jahofmann/clevercoffee-hardware/CleverCoffee_ESP32_SMD/spice/TwoResistors.spice

.SUBCKT TwoResistors 1 2 3
R1 1 3 200
R2 2 3 200
.ENDS
