jahofmann/clevercoffee-hardware/CleverCoffee_ESP32_SMD/CleverCoffee_ESP32.kicad_pcb

## KiCad design CleverCoffee_ESP32_SMD/CleverCoffee_ESP32.kicad_pcb (2023-09-08)

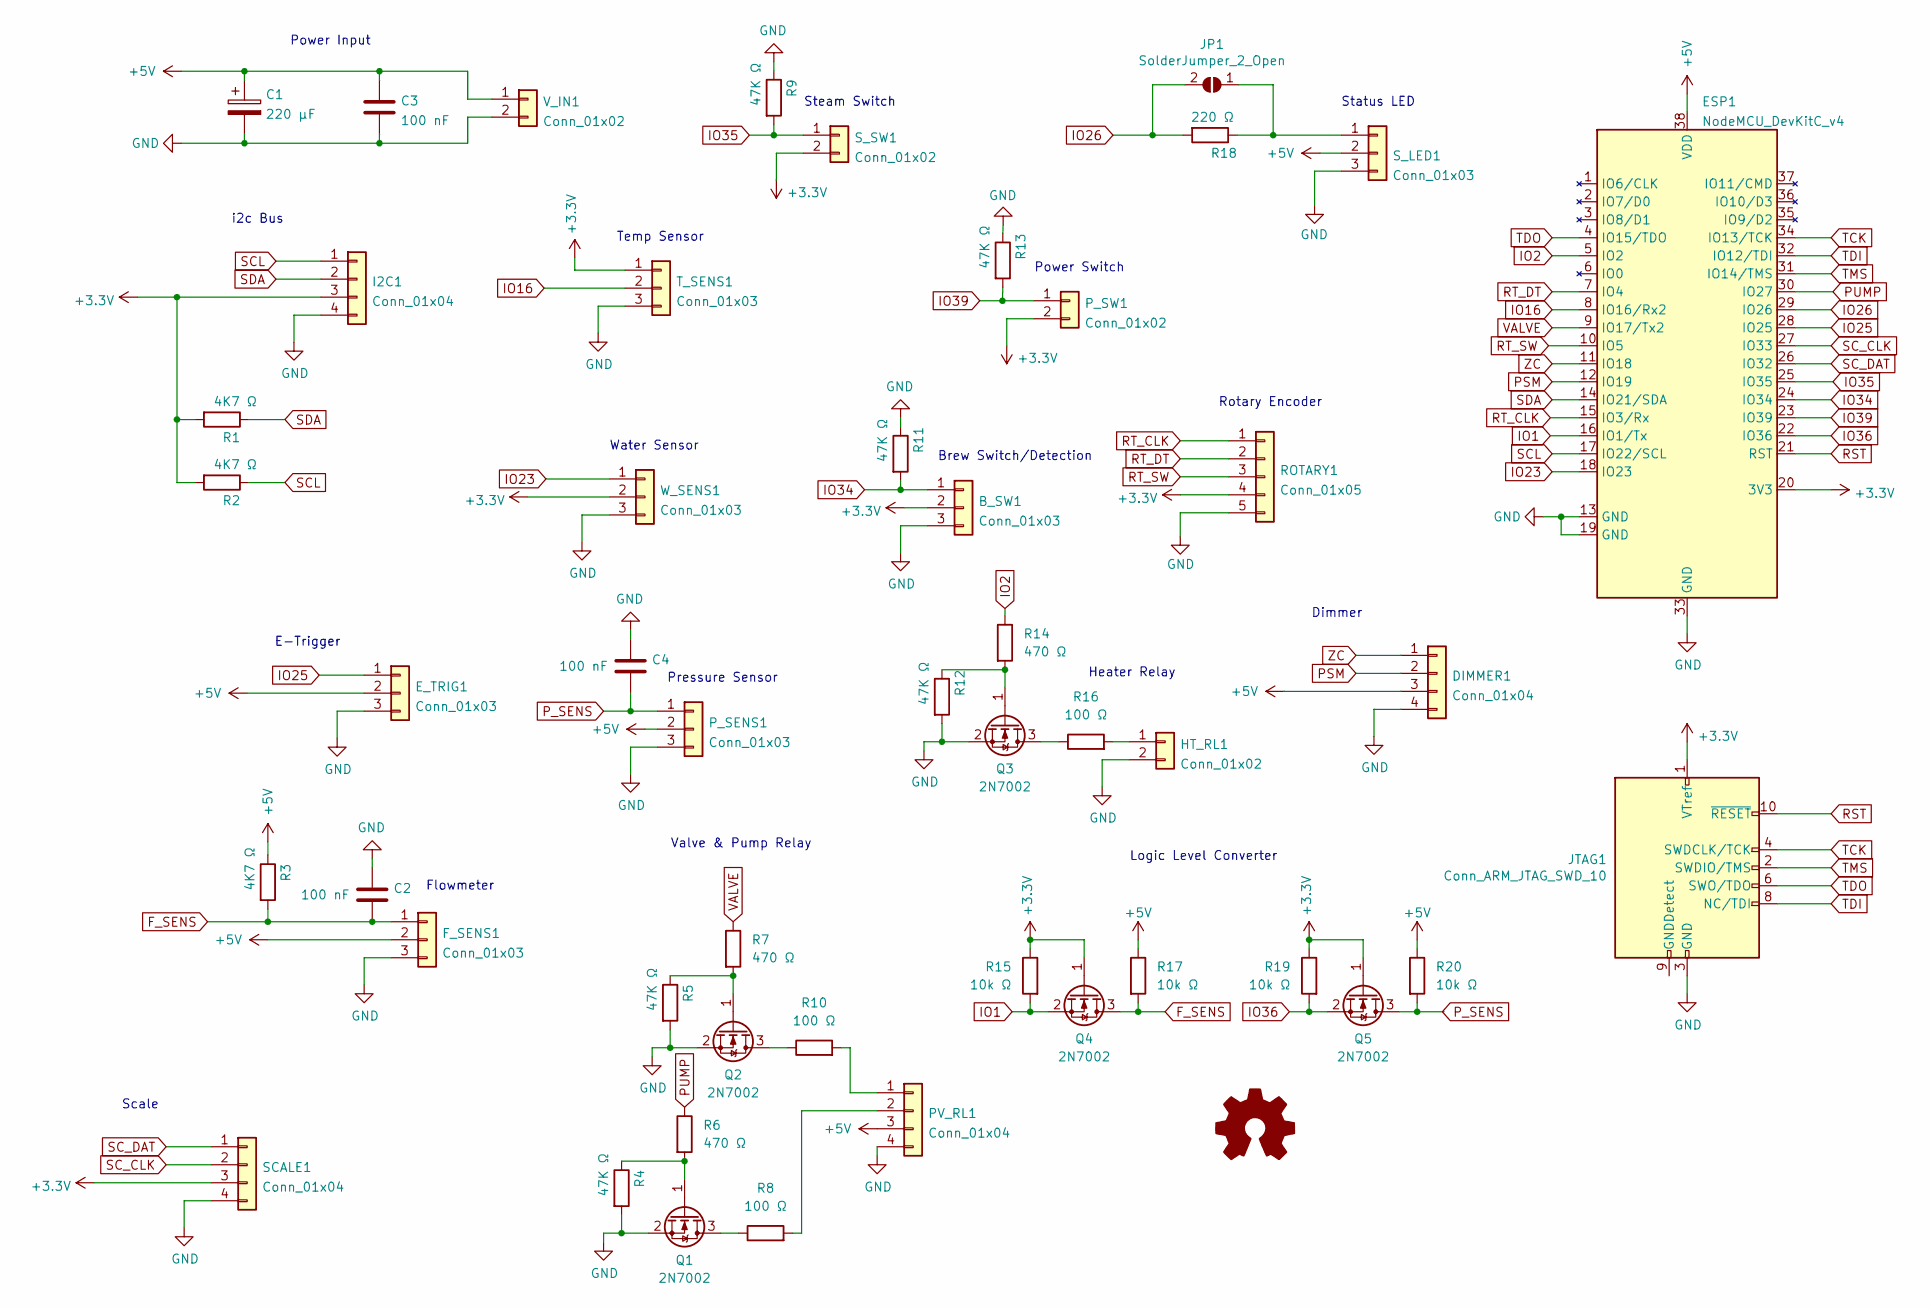
[picture p1: schematic CleverCoffee_ESP32.kicad_sch, ESP32 Breakout Board]

Parts:
B_SW1: Conn_01x03; PinSocket_1x03_P2.54mm_Vertical; JLCPCB BOM false
C1: 220 μF; CP_Radial_D8.0mm_P3.80mm; JLCPCB BOM false
C2, C3, C4: 100 nF; C_0603_1608Metric; LCSC Part C14663
DIMMER1: Conn_01x04; PinSocket_1x04_P2.54mm_Vertical; JLCPCB BOM false
ESP1: NodeMCU_DevKitC_v4; NodeMCU DevKitC v4; JLCPCB BOM false
E_TRIG1: Conn_01x03; PinSocket_1x03_P2.54mm_Vertical; JLCPCB BOM false
F_SENS1: Conn_01x03; PinSocket_1x03_P2.54mm_Vertical; JLCPCB BOM false
HT_RL1: Conn_01x02; PinSocket_1x02_P2.54mm_Vertical; JLCPCB BOM false
I2C1: Conn_01x04; PinSocket_1x04_P2.54mm_Vertical; JLCPCB BOM false
JP1: SolderJumper_2_Open; SolderJumper-2_P1.3mm_Open_Pad1.0x1.5mm; JLCPCB BOM false
JTAG1: Conn_ARM_JTAG_SWD_10; PinHeader_2x05_P2.54mm_Vertical; JLCPCB BOM false
PV_RL1: Conn_01x04; PinSocket_1x04_P2.54mm_Vertical; JLCPCB BOM false
P_SENS1: Conn_01x03; PinSocket_1x03_P2.54mm_Vertical; JLCPCB BOM false
P_SW1: Conn_01x02; PinSocket_1x02_P2.54mm_Vertical; JLCPCB BOM false
Q1, Q2, Q3, Q4, Q5: 2N7002; SOT-23; LCSC Part C8545
R1, R2, R3: 4K7 Ω; C_0603_1608Metric; LCSC Part C23162
R4, R5, R9, R11, R12, R13: 47K Ω; C_0603_1608Metric; LCSC Part C25819
R6, R7, R14: 470 Ω; C_0603_1608Metric; LCSC Part C23179
R8, R10, R16: 100 Ω; C_0603_1608Metric; LCSC Part C22775
R15, R17, R19, R20: 10k Ω; R_0603_1608Metric; LCSC Part C25804
R18: 220 Ω; C_0603_1608Metric; LCSC Part C22962
ROTARY1: Conn_01x05; PinSocket_1x05_P2.54mm_Vertical; JLCPCB BOM false
SCALE1: Conn_01x04; PinSocket_1x04_P2.54mm_Vertical; JLCPCB BOM false
S_LED1: Conn_01x03; PinSocket_1x03_P2.54mm_Vertical; JLCPCB BOM false
S_SW1: Conn_01x02; PinSocket_1x02_P2.54mm_Vertical; JLCPCB BOM false
T_SENS1: Conn_01x03; PinSocket_1x03_P2.54mm_Vertical; JLCPCB BOM false
V_IN1: Conn_01x02; PinSocket_1x02_P2.54mm_Vertical; JLCPCB BOM false
W_SENS1: Conn_01x03; PinSocket_1x03_P2.54mm_Vertical; JLCPCB BOM false

Connections:
+3V3: B_SW1.2, ESP1.20 (3V3), I2C1.3, JTAG1.1 (VTref), P_SW1.2, Q4.1 (G), Q5.1 (G), R1.2, R2.2, R15.1, R19.1, ROTARY1.4, SCALE1.3, S_SW1.2, T_SENS1.1, W_SENS1.2
+5V: C1.1, C3.1, DIMMER1.3, ESP1.38 (VDD), E_TRIG1.2, F_SENS1.2, PV_RL1.3, P_SENS1.2, R3.1, R17.1, R20.1, S_LED1.2, V_IN1.1
F_SENS: C2.2, F_SENS1.1, Q4.3 (D), R3.2, R17.2
GND: B_SW1.3, C1.2, C2.1, C3.2, C4.1, DIMMER1.4, ESP1.13 (GND), ESP1.19 (GND), ESP1.33 (GND), E_TRIG1.3, F_SENS1.3, HT_RL1.2, I2C1.4, JTAG1.3 (GND), JTAG1.5 (GND), PV_RL1.4, P_SENS1.3, Q1.2 (S), Q2.2 (S), Q3.2 (S), R4.2, R5.2, R9.1, R11.1, R12.2, R13.1, ROTARY1.5, SCALE1.4, S_LED1.3, T_SENS1.3, V_IN1.2, W_SENS1.3
IO1: ESP1.16 (IO1/Tx), Q4.2 (S), R15.2
IO2: ESP1.5 (IO2), R14.1
IO16: ESP1.8 (IO16/Rx2), T_SENS1.2
IO23: ESP1.18 (IO23), W_SENS1.1
IO25: ESP1.28 (IO25), E_TRIG1.1
IO26: ESP1.29 (IO26), JP1.2 (B), R18.2
IO34: B_SW1.1, ESP1.24 (IO34), R11.2
IO35: ESP1.25 (IO35), R9.2, S_SW1.1
IO36: ESP1.22 (IO36), Q5.2 (S), R19.2
IO39: ESP1.23 (IO39), P_SW1.1, R13.2
unnamed: HT_RL1.1, R16.2
unnamed: JP1.1 (A), R18.1, S_LED1.1
unnamed: PV_RL1.1, R10.2
unnamed: PV_RL1.2, R8.2
unnamed: Q1.3 (D), R8.1
unnamed: Q1.1 (G), R4.1, R6.2
unnamed: Q2.3 (D), R10.1
unnamed: Q2.1 (G), R5.1, R7.2
unnamed: Q3.3 (D), R16.1
unnamed: Q3.1 (G), R12.1, R14.2
PSM: DIMMER1.2, ESP1.12 (IO19)
PUMP: ESP1.30 (IO27), R6.1
P_SENS: C4.2, P_SENS1.1, Q5.3 (D), R20.2
RST: ESP1.21 (RST), JTAG1.10 (~RESET)
RT_CLK: ESP1.15 (IO3/Rx), ROTARY1.1
RT_DT: ESP1.7 (IO4), ROTARY1.2
RT_SW: ESP1.10 (IO5), ROTARY1.3
SCL: ESP1.17 (IO22/SCL), I2C1.1, R2.1
SC_CLK: ESP1.27 (IO33), SCALE1.2
SC_DAT: ESP1.26 (IO32), SCALE1.1
SDA: ESP1.14 (IO21/SDA), I2C1.2, R1.1
TCK: ESP1.34 (IO13/TCK), JTAG1.4 (SWDCLK/TCK)
TDI: ESP1.32 (IO12/TDI), JTAG1.8 (NC/TDI)
TDO: ESP1.4 (IO15/TDO), JTAG1.6 (SWO/TDO)
TMS: ESP1.31 (IO14/TMS), JTAG1.2 (SWDIO/TMS)
VALVE: ESP1.9 (IO17/Tx2), R7.1
ZC: DIMMER1.1, ESP1.11 (IO18)

Notes on the sheet:
Status LED
i2c Bus
Logic Level Converter
Power Switch
Brew Switch/Detection
E-Trigger
Temp Sensor
Rotary Encoder
Steam Switch
Heater Relay
Scale
Pressure Sensor
Dimmer
Flowmeter
Power Input
Valve & Pump Relay
Water Sensor

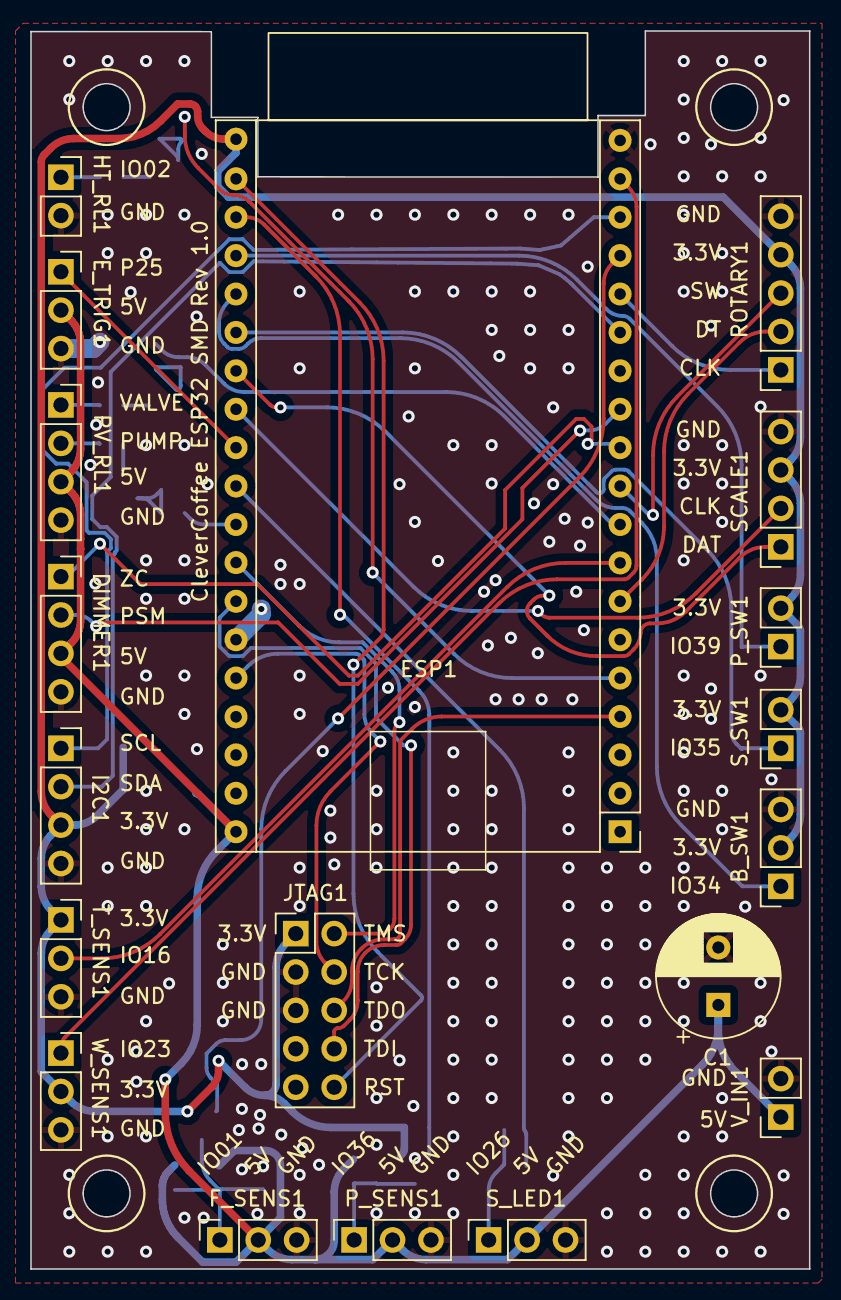
[picture p2: board CleverCoffee_ESP32.kicad_pcb from above]

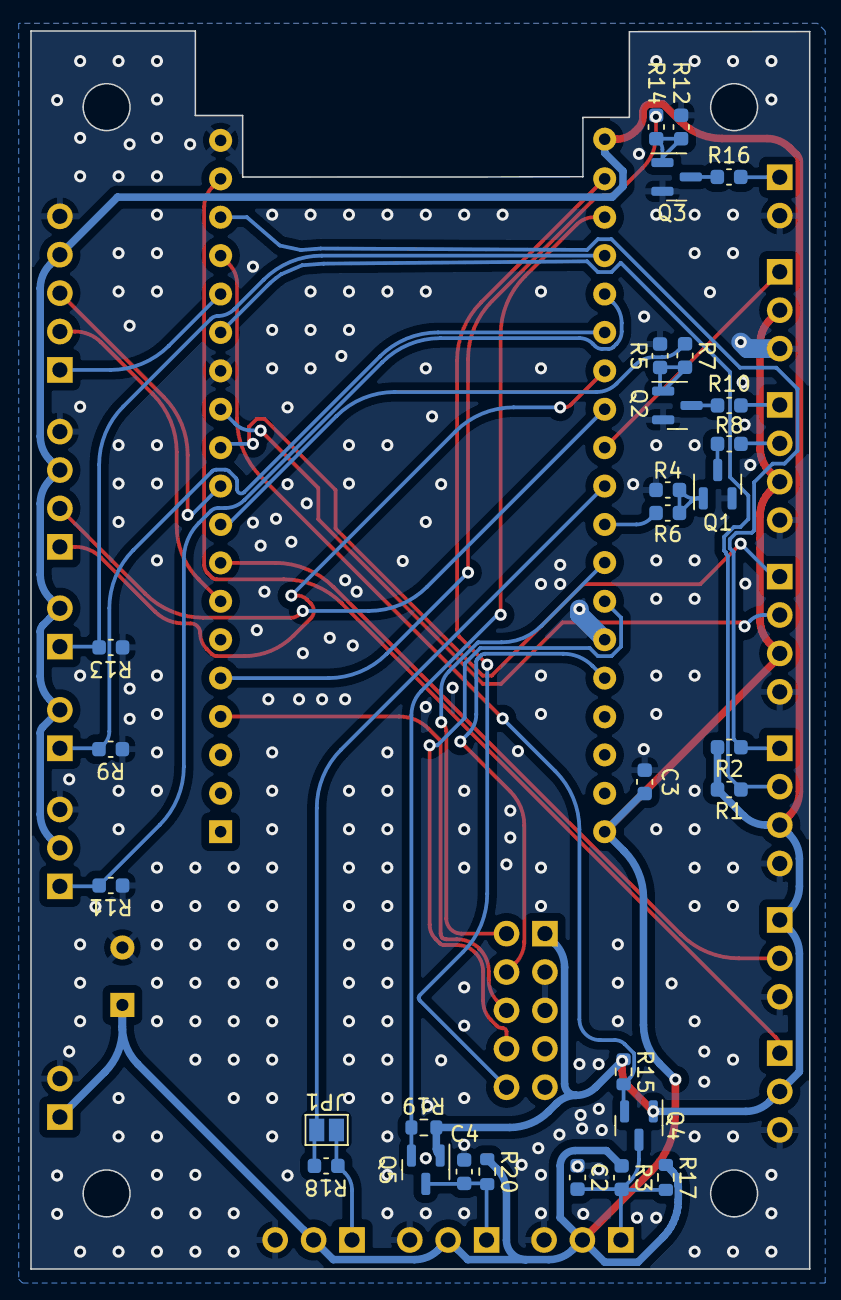
[picture p3: board CleverCoffee_ESP32.kicad_pcb from below]

Board: 2 copper layers, 51.5 x 81.9 mm, 48 parts (29 on the bottom side), 41 nets.
