jahofmann/clevercoffee-hardware/(commit log)

2023-09-07 Started reworking PCB for JLCPCB assembly
    [CleverCoffee_ESP32.kicad_pcb, CleverCoffee_ESP32.kicad_sch]
2023-09-07 Finishes SMD version for production
    [CleverCoffee_ESP32.kicad_pcb]
2023-09-08 Finalize DRC and add production files
    [CleverCoffee_ESP32.kicad_pcb, CleverCoffee_ESP32.kicad_sch]
2023-09-08 Final touches and production files
    [CleverCoffee_ESP32.kicad_pcb, CleverCoffee_ESP32.kicad_sch, bom.csv, designators.csv, positions.csv]
2023-10-04 Adds SPICE model
    [CleverCoffee_ESP32.kicad_sch]
